AntonSangho/moya-worklog/image/w1_2022.png

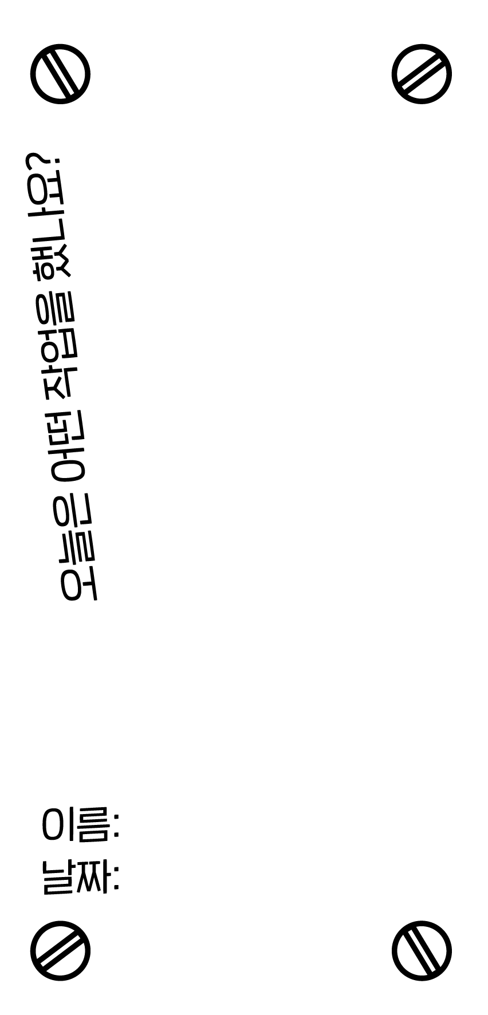
image/w1_2022.png
