AntonSangho/moya-worklog/image/w2_2022.png

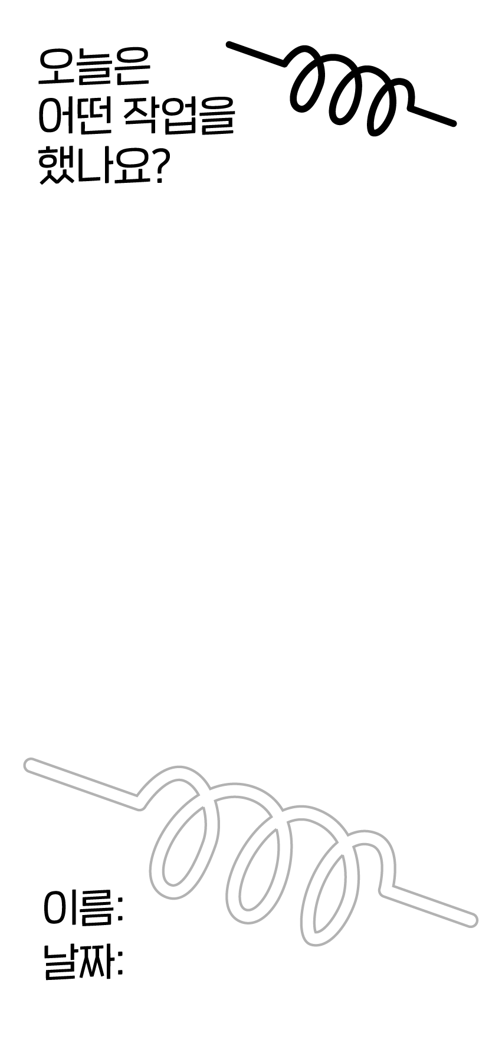
image/w2_2022.png
