AntonSangho/moya-worklog/image/w3_2022.png

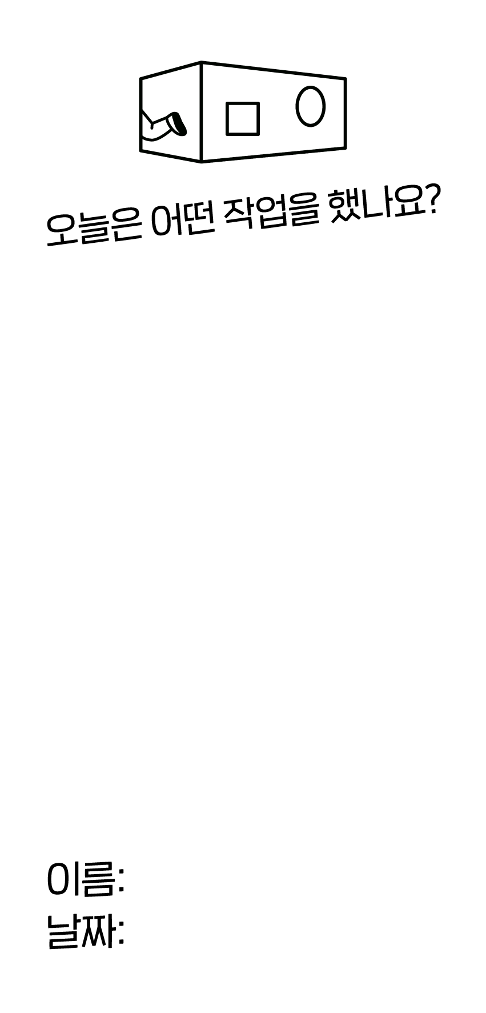
image/w3_2022.png
