AntonSangho/moya-worklog/image/w4_2022.png

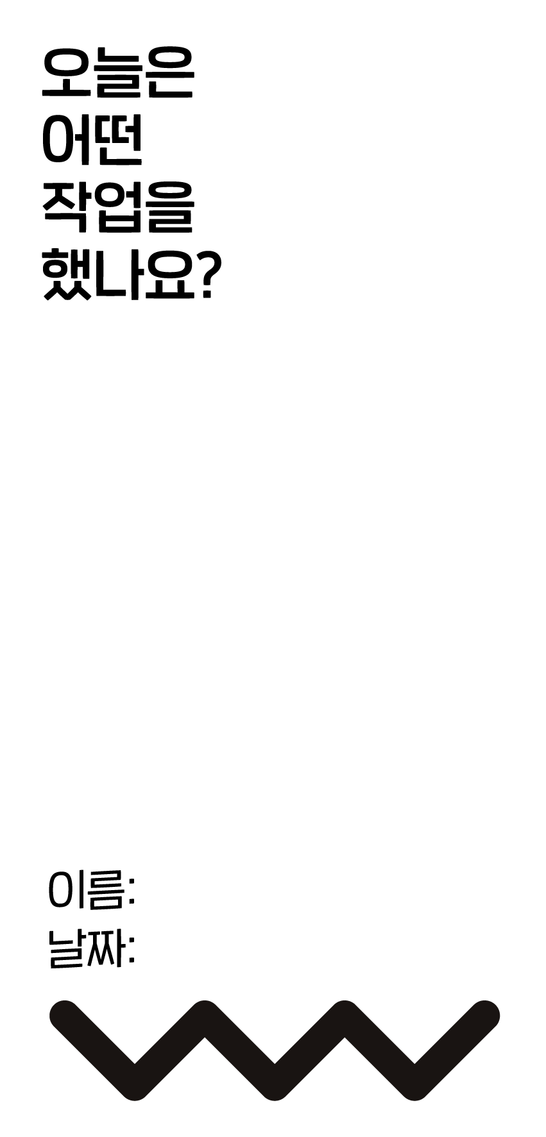
image/w4_2022.png
