AntonSangho/moya-worklog/image/w5_2022.png

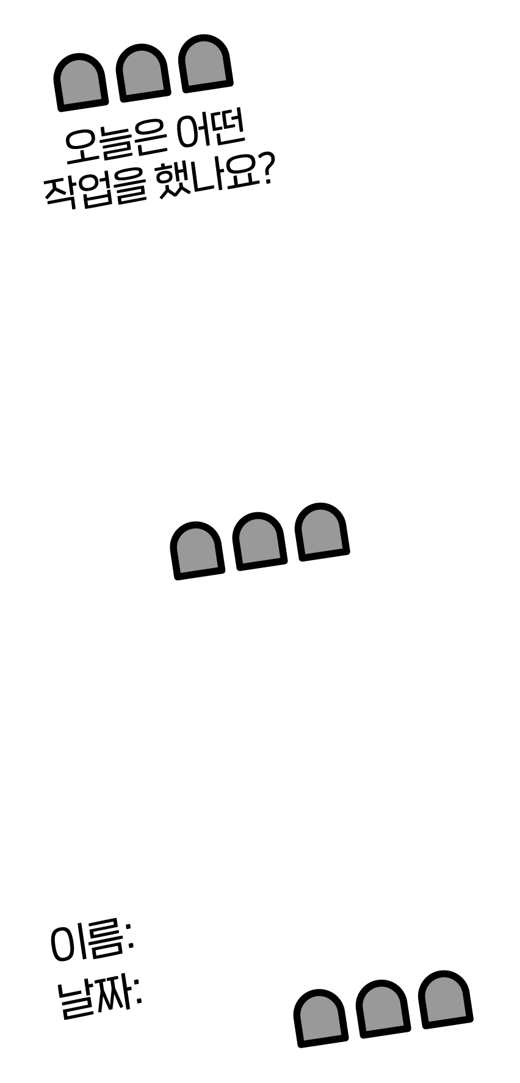
image/w5_2022.png
