AntonSangho/moya-worklog/Legarcy/image/w1.png

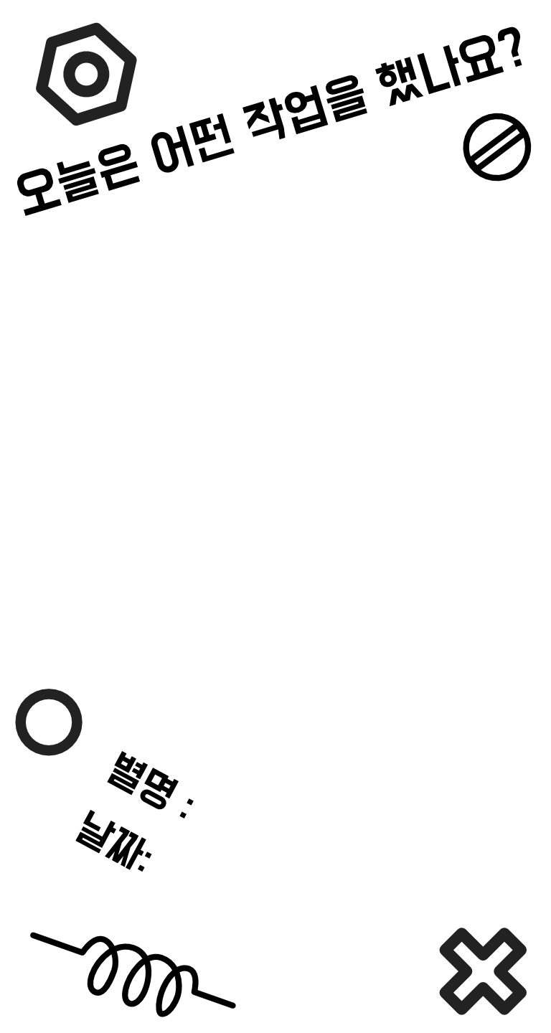
Legarcy/image/w1.png
