AntonSangho/moya-worklog/Legarcy/image/w1_tt.png

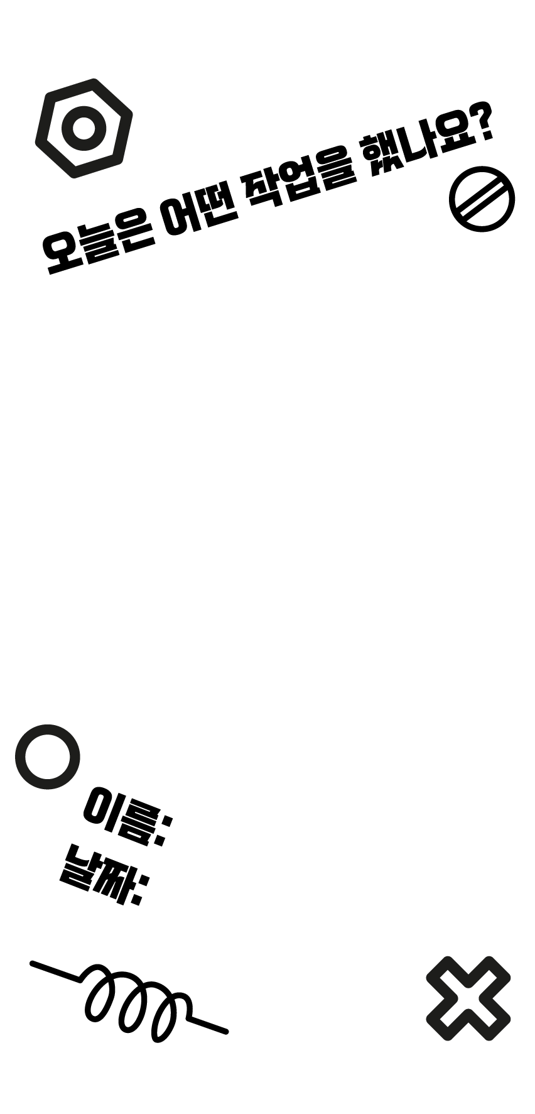
Legarcy/image/w1_tt.png
