AntonSangho/moya-worklog/Legarcy/image/w2.png

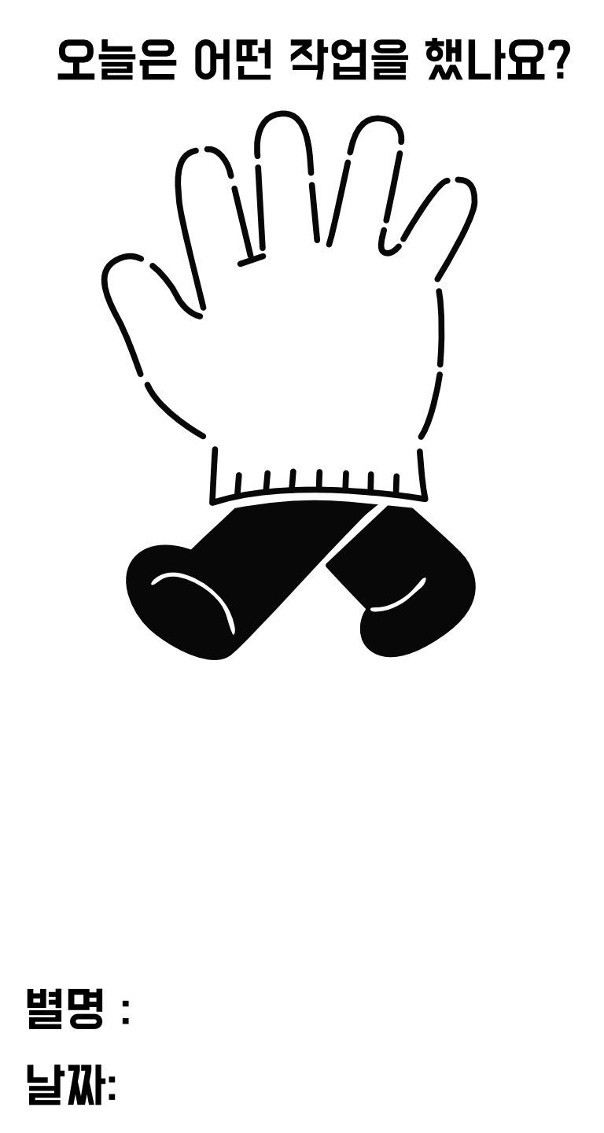
Legarcy/image/w2.png
