AntonSangho/moya-worklog/Legarcy/image/w2_tt.png

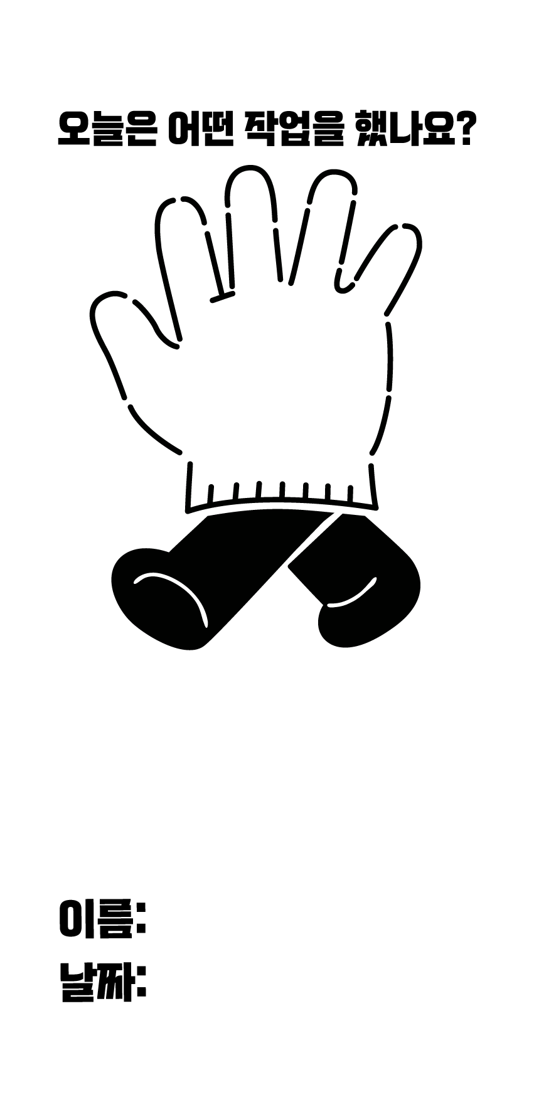
Legarcy/image/w2_tt.png
