AntonSangho/moya-worklog/Legarcy/image/w3.png

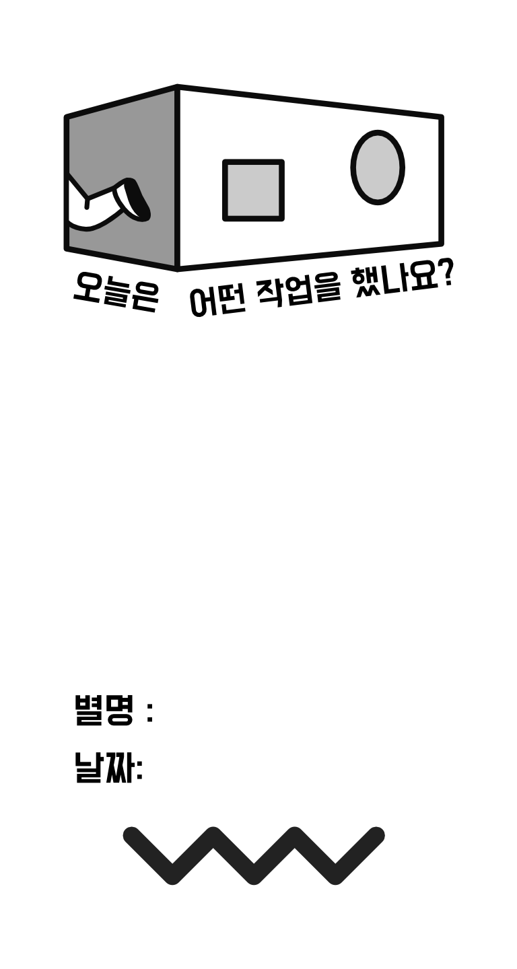
Legarcy/image/w3.png
