AntonSangho/moya-worklog/Legarcy/image/w4.png

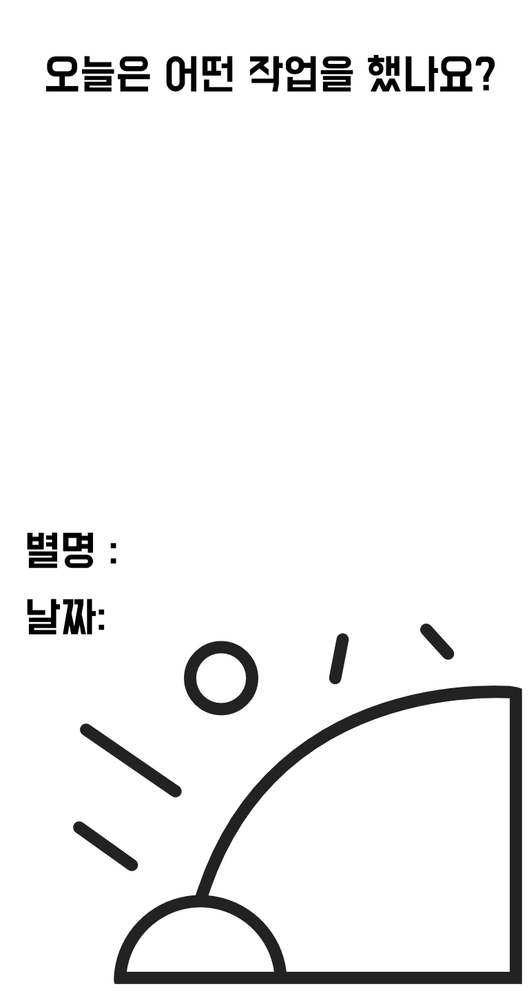
Legarcy/image/w4.png
