AntonSangho/moya-worklog/Legarcy/image/w4_tt.png

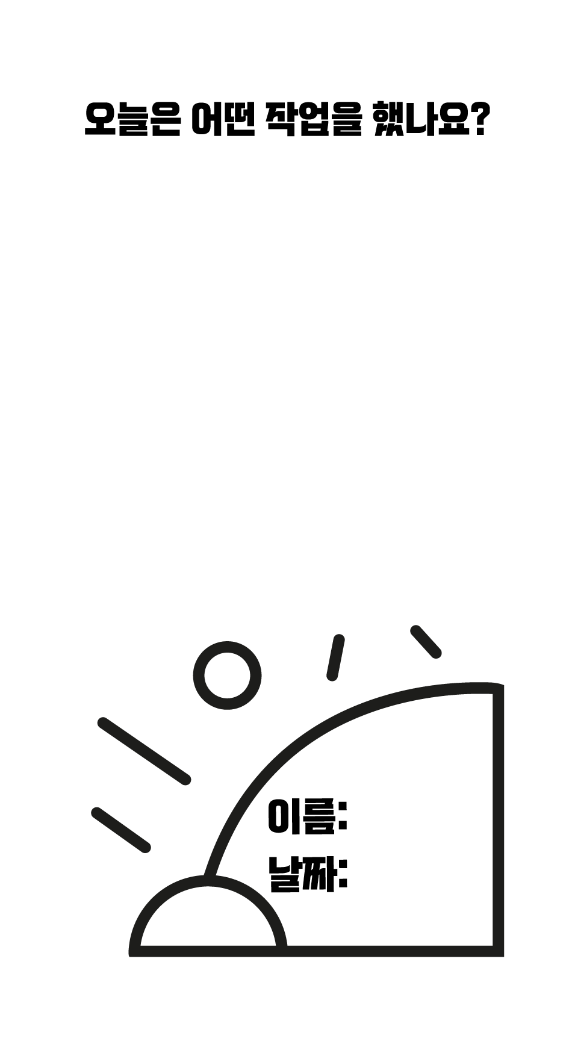
Legarcy/image/w4_tt.png
