AntonSangho/moya-worklog/Legarcy/image/w5.png

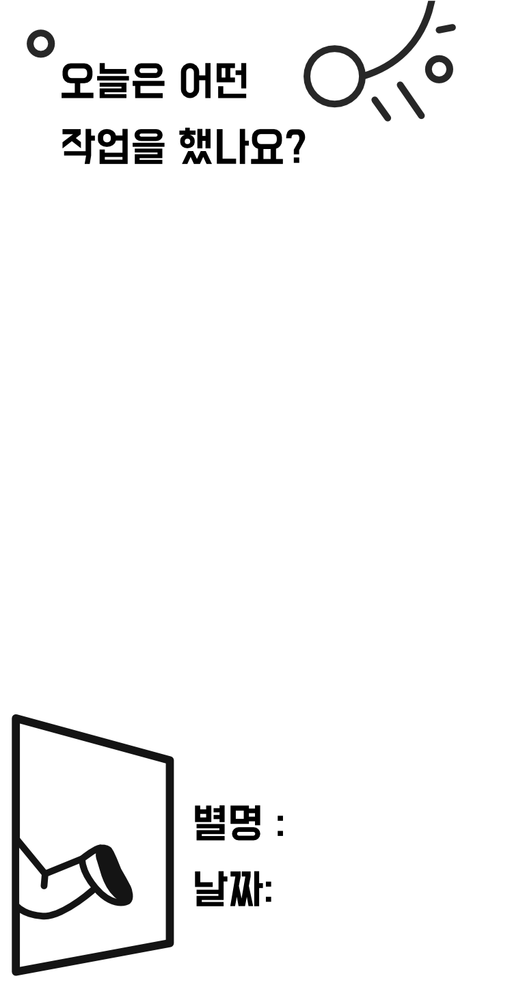
Legarcy/image/w5.png
