AntonSangho/moya-worklog/Legarcy/image/w5_tt.png

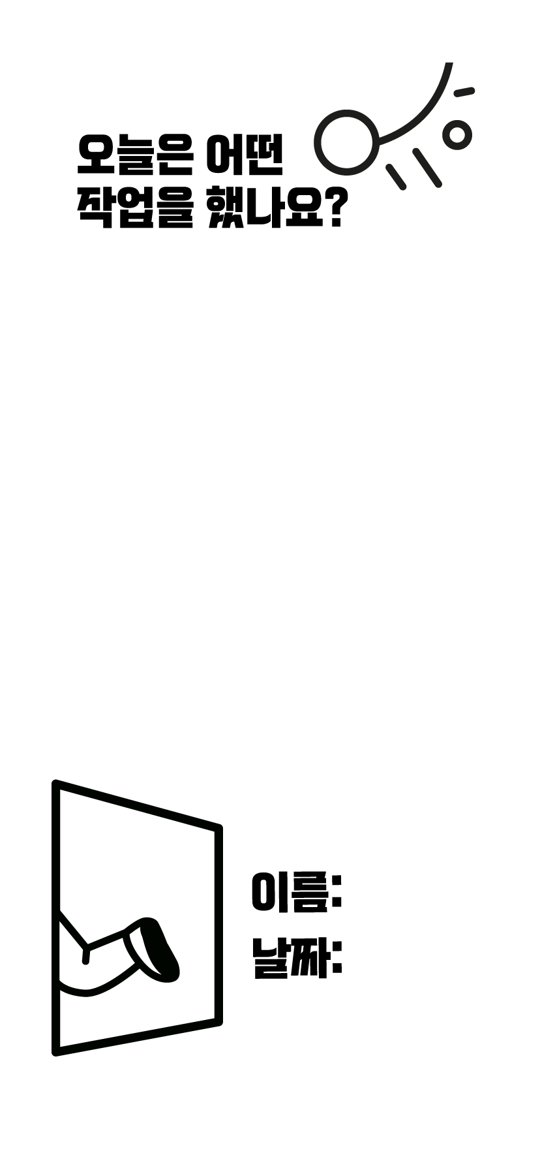
Legarcy/image/w5_tt.png
