AntonSangho/moya-worklog/Legarcy/picture/perma-proto_hat.jpg

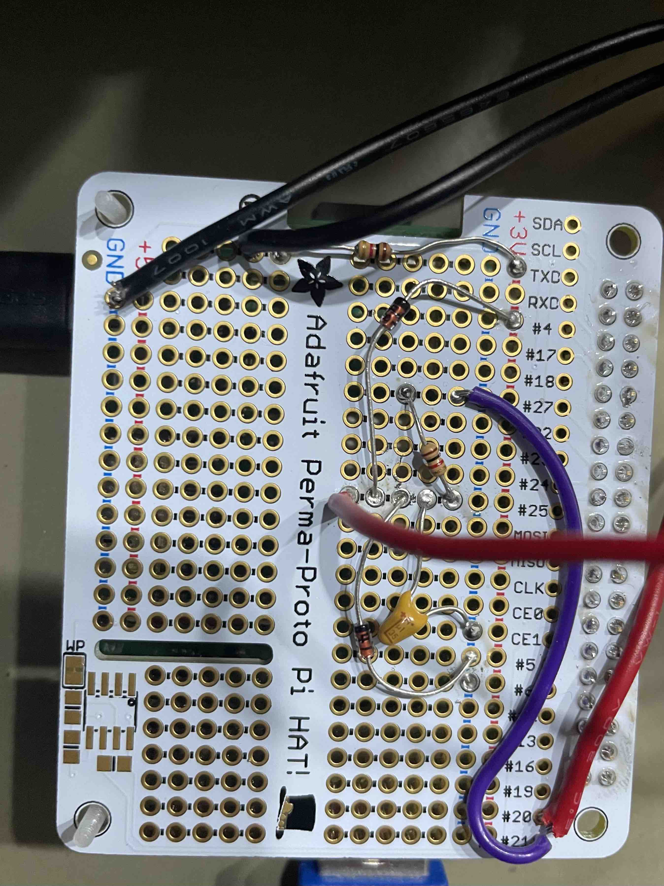
Legarcy/picture/perma-proto_hat.jpg
