AntonSangho/moya-worklog/hardware/schematic/raspberry-pi-power-led-gpio-wiringpinout-diagram.jpg

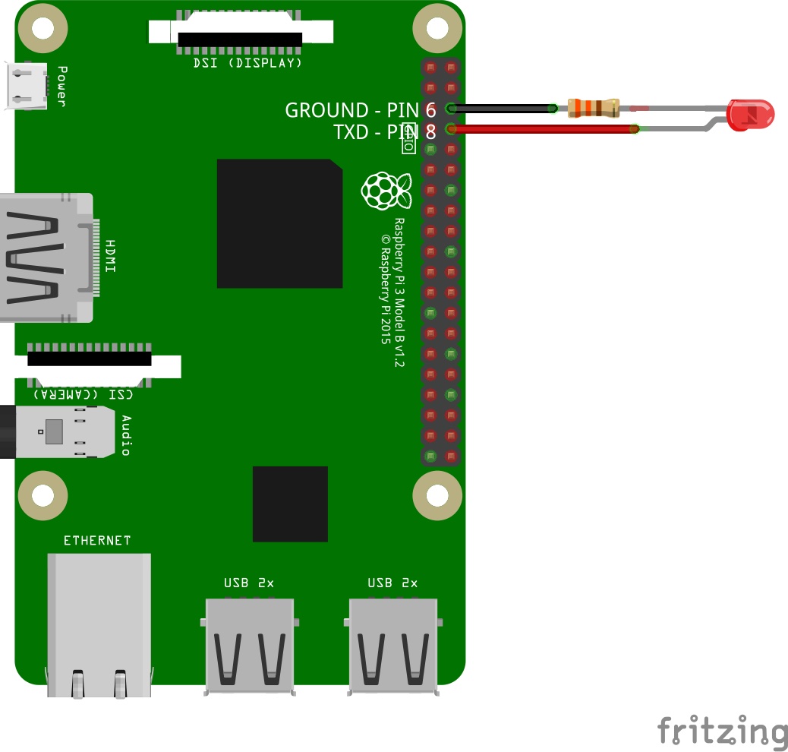
hardware/schematic/raspberry-pi-power-led-gpio-wiringpinout-diagram.jpg
