AntonSangho/moya-worklog/hardware/schematic/moya-worklog_sch.png

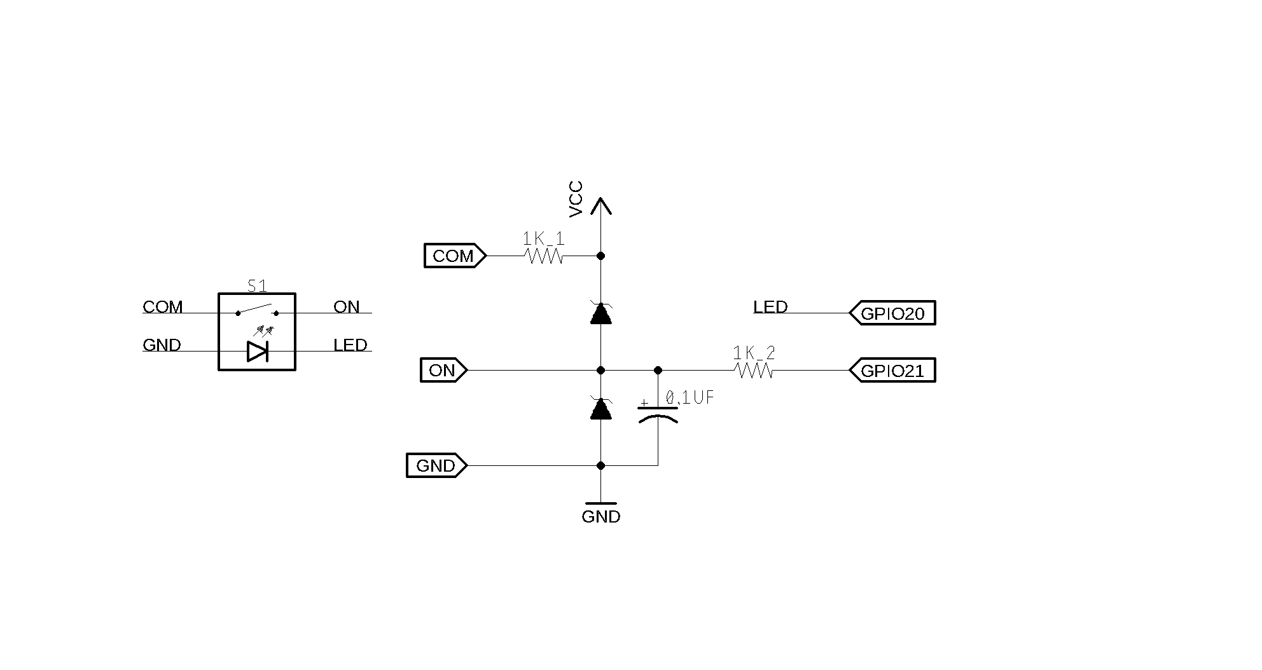
hardware/schematic/moya-worklog_sch.png
