AntonSangho/moya-worklog/Legarcy/picture/moya-worklog_pic.png

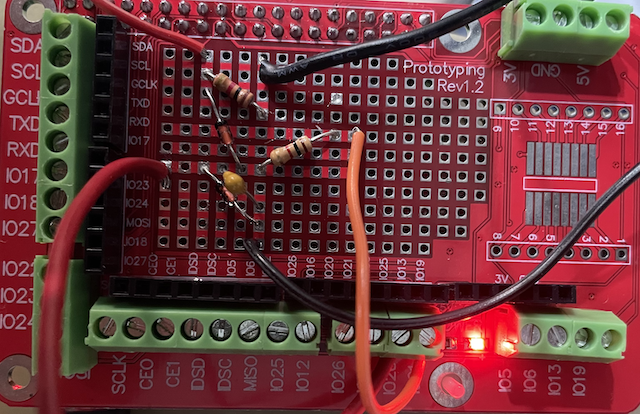
Legarcy/picture/moya-worklog_pic.png
