AntonSangho/moya-worklog/odroid/print_odroid.py

"""
Requirement
Odroid C-4
Bixolon

"""
# !/bin/python

import RPi.GPIO as GPIO
import time
import os
import cups
import random
from escpos import *
from PIL import Image

conn = cups.Connection()
printers = conn.getPrinters()
#p = printer.Usb(0x1c8a, 0x3a0e, in_ep=0x81, out_ep=0x02)

# Sam4s Giant 100
p = printer.Usb(0x1c8a, 0x3a0e, in_ep=0x81, out_ep=0x02)

#Bixolon Printer
#p = printer.Usb(0x1504, 0x006e, in_ep=0x81, out_ep=0x02)

file1 = "/home/odroid/moya-worklog/image/w1_2022.png"
file2 = "/home/odroid/moya-worklog/image/w2_2022.png"
file3 = "/home/odroid/moya-worklog/image/w3_2022.png"
file4 = "/home/odroid/moya-worklog/image/w4_2022.png"
file5 = "/home/odroid/moya-worklog/image/w5_2022.png"
filelist = [file1, file2, file3, file4, file5]

IRQ_GPIO_PIN = 25
#LED_GPIO_PIN = 8
LED_GPIO_PIN = 12
#IRQ_EDGE = GPIO.FALLING
IRQ_EDGE = GPIO.RISING
count = 0

def print_status():
    global count
    GPIO.output(LED_GPIO_PIN, GPIO.HIGH)
    print(count)
    count = 0

def Print_sam4s(channel):
    im = Image.open(random.choice(filelist))
    out = im.resize((480, 1000))
    p.image(out)
    p.cut()

def print_test(channel):
    global count 
    count +=1
    print("print_test" + str(count))
    im = Image.open(random.choice(filelist))
    p.text(str(count) + "\n")
    p.cut()


if __name__ == '__main__':
    GPIO.setmode(GPIO.BCM)
    #GPIO.setup(IRQ_GPIO_PIN, GPIO.IN, pull_up_down=GPIO.PUD_UP)
    GPIO.setup(IRQ_GPIO_PIN, GPIO.IN, pull_up_down=GPIO.PUD_DOWN)
    GPIO.setup(LED_GPIO_PIN, GPIO.OUT)
    # 기존의 pin이 high였던것을 제거하기위함
    #time.sleep(2)
    #GPIO.remove_event_detect(IRQ_GPIO_PIN)
    GPIO.add_event_detect(IRQ_GPIO_PIN, IRQ_EDGE, callback=Print_sam4s, bouncetime=2000)
    ## 테스트해별 경우 아래 주석 제거
    #GPIO.add_event_detect(IRQ_GPIO_PIN, IRQ_EDGE, callback=print_test, bouncetime=2000)
    

print('Press Ctrl-C to exit')
try:
    while True:
        GPIO.output(LED_GPIO_PIN, GPIO.HIGH)
        time.sleep(1)
except KeyboardInterrupt:
    GPIO.output(LED_GPIO_PIN, GPIO.LOW)
    GPIO.cleanup()
    sys.exit(0)
