AntonSangho/moya-worklog/(commit log)

2021-11-02 실행파일 추가
2021-11-02 이미지파일 추가
2021-11-02 Bixolon 330-ii driver 추가
2021-11-02 Readme파일 추가
2021-11-13 부팅파일 실핼 경로 변경
2021-11-13 프린프 파일 경로 변경
2021-11-13 오타수정
2021-11-16 티티섬용 용지와 실행파일추가
2021-11-16 작업일지 파일 만드는 법 추가
2021-11-16 작업일지 원본파일
2021-11-16 작업일지원본 삭제
2021-11-16 worklog_template.ai추가
2021-11-16 새로운 GPIO control방식추가
2021-11-17 pint_2.py pinter 기능추가
2021-11-17 GPIO status로 제어되는 방식으로 새로 만듬
2021-11-17 부품추가
2021-11-17 회로도 추가
2021-11-17 clamp diode 회로 사진
2021-11-17 티티섬용과 일반용 구분
2021-11-17 gpio event detect용 티티섬 추가
2021-11-17 picture, schematic폴더 생성
2021-11-17 gpio설명추가
2021-11-17 회로도 설명 제거
2021-12-08 sam4s 프린터용 스크립트 추가
2021-12-14 job을 제거하는 기능을 예전 출력 스크립트에 추가
2021-12-14 티티섬용 용지 문구 수정, 템플렛 문구수정
2021-12-14 gpio status로 제어되는 방식의 스크립트에 job없애는 기능 추가
2021-12-14 perma proto hat 으로 구성한 회로사진 추가
2021-12-22 티티믹용 용지크기변경
2021-12-23 티티섬 작동되는 용지설정완료
2021-12-23 작업일지 템플릿 업데이트
2022-06-09 sam4s 버전
2022-06-15 설계도면 추가
2022-06-15 설계도면 이미지파일 추가
2022-06-15 cnc 프로젝트 파일추가
2022-07-05 빅솔론에서 적용하기
2022-07-15 빅솔론 작업완료
2022-08-08 시리얼 프린트용 스크립트추가
2022-08-08 art예제 테스트
2022-08-11 serial printer텍스트 출력으로 설정
2022-08-13 이전 작업 제거기능 추가
2022-08-20 순번과 날짜시간나오도록함
2022-08-23 번호 출력테스트
2022-09-21 cancel -a 제거
2022-09-24 새로운 작업일지디자인적용
2022-09-24 새로운 디자인 실행파일 추가
2022-09-24 새로운 작업일지일러스트파일추가
2022-09-24 라즈베리파이 위 커버 추가
2022-10-04 레이저커팅 파일업데이트
2022-10-04 뒤에 조립 구멍도면 수정
2022-10-04 소프파워버튼 서브모듈 추가
2022-10-04 전원 확인용 led 연결 그림추가
2022-10-04 전원 확인용 led 연결그림 변경
2022-10-05 용지 나오는 구멍을 더 넓힘
2022-11-01 odroid테스트
2022-11-05 submodle도 같이 다운로드되고 업데이트 되도록 추가
2022-11-05 리셋버튼 설치스크립트 추가
2022-11-05 sam4s requirment문제 해결방법 추가
2022-11-05 불필요한 install제거
2022-11-06 odroid용 테스트 스크립트 추가
2022-11-06 odroid led 켜지도록 추가
2022-11-06 odroid tutorial 추가
2022-11-06 readme 수정
2022-11-06 odroid pin 표 추가
2022-11-08 tutorial 추가
2022-11-10 LED전원 꺼지도록 수정, 테스트용 스크립트 추가
    [print_test.py]
2022-11-10 테스트 프린트수정
2022-11-10 wiring 추가
2022-11-10 폴더명 수정
2022-11-25 오드로이드 실행파일 수정, 부팅설정 추가
    [print_odroid.py]
2022-11-25 프린트 구멍 수정
2022-11-25 버튼led gpio를 변경
2022-11-25 readme수정
2022-11-28 odroid 시작하기전에 GPIO.remove_event_detect를 실행함
2022-11-28 odroid 위치 수정
2022-11-30 도면파일 수정
2022-11-30 오드로이드 폴더 분리
2022-11-30 오드로이드 이미지추가
2022-11-30 오드로이드 이미지 추가
2022-12-02 Rpi.GPIO-Odroid을 submodule에 추가
2023-04-01 테스트 동작되는 코드
2023-07-01 uart연결 ,무선연결 추가
2023-07-06 설치 스크립트 추가
2023-07-13 install.sh requirement imagepath 수정
    [print_odroid.py]
2023-07-13 python3로 설치수정
2023-07-30 재단방법 추가
2023-07-30 구멍 사이즈 수정
2025-08-14 pin2번으로 변경
2025-08-14 Readme파일업데이트
2026-02-01 Add Raspberry Pi installation guide for AI agent
    - Step-by-step setup instructions for Raspbian 64-bit Lite
    - Bixolon SRP-330II printer configuration
    - GPIO pin mapping and systemd service setup
2026-02-01 Python 3.13 호환을 위해 requirements.txt 업데이트
    - 엄격한 버전 고정 제거, 최소 버전으로 변경
    - Debian 13 지원을 위해 RPi.GPIO를 rpi-lgpio로 교체
    - 불필요한 시스템 패키지 제거
    - 주석 추가
2026-02-01 README.md에 AI 에이전트 자동 설치 방법 추가
    - install.md를 이용한 자동 설치 섹션 추가
    - 사전 준비 사항 및 실행 방법 안내
    - 기존 수동 설치 방법은 그대로 유지
2026-02-01 GPIO 버튼 핀 호환성 통합 (GPIO 2, 21 모두 지원)
    - print_Bixolon.py: GPIO 2, 21 두 핀 모두 버튼으로 허용
    - install.md: 두 GPIO 옵션 문서화
    Fixes #8
    [print_Bixolon.py]
2026-05-17 Fix hardcoded paths and GPIO pin for Raspberry Pi 3 compatibility
    - Replace /home/anton paths with /home/pi (issue #15)
    - Add force=True to logging.basicConfig to override escpos handler (issue #16)
    - Change BUTTON_PIN from GPIO2 to GPIO4: GPIO2(SDA) has hardware pull-up
    that cannot be overridden by software PUD_DOWN, causing always-HIGH reads
    [print_sam4s_production.py]
2026-05-17 Improve performance and stability (issue #19)
    - RotatingFileHandler: 1MB 초과 시 자동 rotation, 최대 3개 보관
    - Image preload cache: 시작 시 5개 이미지 전처리, 출력 시 디스크 I/O 없음
    - USB auto-reconnect: 출력 실패 시 최대 3회 자동 재연결
    - Thread-based button watch: 메인 루프 폴링 제거, 50ms 데몬 스레드로 분리
    - threading.Lock: 동시 출력 방지
    [print_sam4s_production.py]
2026-05-17 Add systemd service for auto-start on boot
    부팅 시 자동 실행, 프로세스 종료 시 5초 후 자동 재시작
2026-05-17 Update README for Raspberry Pi 3 migration
    - Pin Map: Print Button GPIO 2 → 4
    - 부팅 자동 시작: moya-printer.service 기준으로 업데이트
    - 파일 설명 및 업데이트 이력 반영
2026-05-17 Add Raspberry Pi Imager setup guide to README
    username=pi 필수 설정 안내 추가 (issue #18)
    잘못된 username 설정 시 경로 오류 발생 경고 포함
2026-05-17 Refactor code, fix requirements, improve directory structure
    issue #17: requirements-64bit.txt
    - escpos>=1.9 제거 (python-escpos와 네임스페이스 충돌)
    - 불필요한 패키지 정리, setuptools 추가 (pkg_resources 제공)
    issue #10: print_sam4s_production.py 리팩토링
    - 타입 힌트 추가
    - 상수 분리 (DEBOUNCE_SEC, BUTTON_POLL_SEC 등)
    - 함수 분리 (_blink_led, _print_text)
    - 전역 변수명 명확화 (printer_instance → printer, count → print_count)
    issue #12: 디렉토리 구조 개선
    - Legarcy/ → legacy/ (오타 수정)
    - Schematic/ + Drawing/ → hardware/schematic, hardware/drawing
    - odroid/ → legacy/odroid/
    - README 경로 및 파일 목록 트리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
    [image.py, insert.py, print.py, print_Bixolon.py, print_new.py, print_new_tt.py, print_odroid.py, print_sam4s.py]
2026-05-17 Add ExecStartPre to kill stray processes before service start
    수동 실행 프로세스가 남아있을 때 서비스 재시작 시 중복 실행 방지
2026-05-17 Remove ExecStartPre from service file
    pkill -f 가 자기 자신의 bash 프로세스도 매칭하여 SIGTERM으로 스스로 종료되는 문제 수정.
    수동 실행 방지는 systemd 서비스만 사용하는 것으로 운영 절차로 대응.
2026-05-17 Separate Odroid C4 docs from README
    - README: 라즈베리파이 전용으로 정리
    - docs/maintenance-odroid-c4.md: Odroid C4 유지보수 내용 분리 보관
2026-05-17 Odroid C4 코드 개선: 로그 로테이션, 이미지 캐싱, USB 재연결, 스레드 방식
    - RotatingFileHandler(1MB, 3개 보관) 추가
    - preload_images(): 시작 시 전체 이미지 캐싱
    - reconnect_printer(): USB 에러 시 3회 자동 재연결
    - button_watcher() daemon thread: 50ms 폴링 방식 (RPi 버전과 동일 패턴)
    - from escpos import * → from escpos.printer import Usb 업데이트
    - requirements.txt: 시스템 패키지 제거, python-escpos>=2.2.0 업그레이드
    Closes #20
2026-05-17 Fix Odroid path: /home/odroid → /root (root user home)
    [print_odroid.py]
2026-05-17 Fix startup false trigger: wait 0.5s for GPIO to settle
    [print_odroid.py]
2026-05-17 Update Odroid C4 maintenance doc: venv, RPi.GPIO-Odroid, systemd 설치 가이드 추가
2026-05-17 Update Odroid C4 docs: Ubuntu 22.04 이미지, root 계정, 전체 설치 가이드 정비
2026-05-17 Update changelog: v2.1.0 항목 추가
2026-05-17 Fix service startup: wait for USB device initialization before start
    Add systemd-udev-settle.service to After= so the printer service
    waits for all udev events (including USB printer recognition) to
    complete before starting.
2026-05-17 Add SD card health check to Odroid C4 troubleshooting process
    Add step 4 (SD card status check) to the troubleshooting flow:
    dmesg I/O error check, tune2fs filesystem error count, df/mount
    status, and FAT partition fsck procedure.
2026-05-17 Update changelog: SD카드 점검 및 USB 부팅 대기 설정 항목 추가
2026-05-24 Add Yocto Stage 4-5 dev log for blog post
    PyPI 레시피 작성 실전 경험 10가지 팁과 RPi3 systemd 이미지
    부팅까지의 과정을 기록한 블로그용 마크다운 문서 추가.
